barnscarter-ops/portalbox/enclosure/renders/front.png

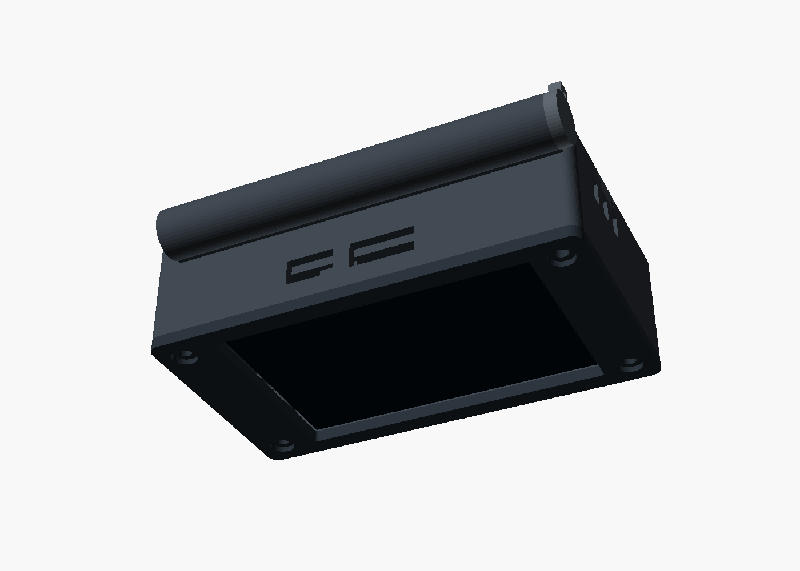
enclosure/renders/front.png
