barnscarter-ops/portalbox/enclosure/renders/rear.png

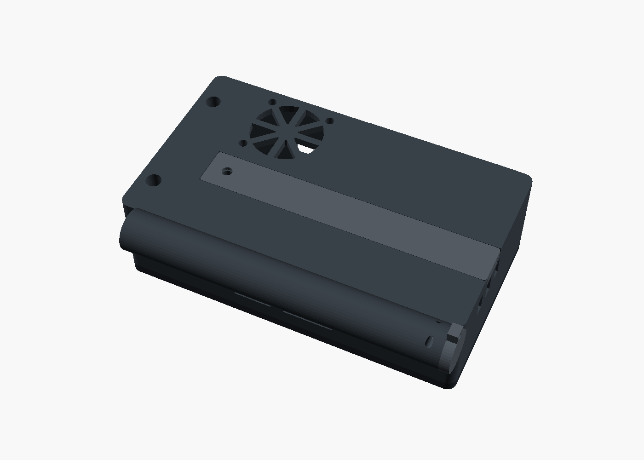
enclosure/renders/rear.png
