barnscarter-ops/portalbox/enclosure/renders/top-edge.png

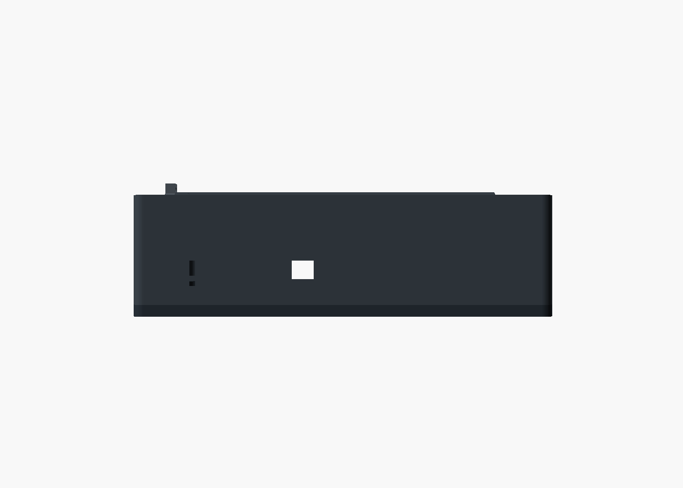
enclosure/renders/top-edge.png
