barnscarter-ops/portalbox/enclosure/draft-stl/button.stl

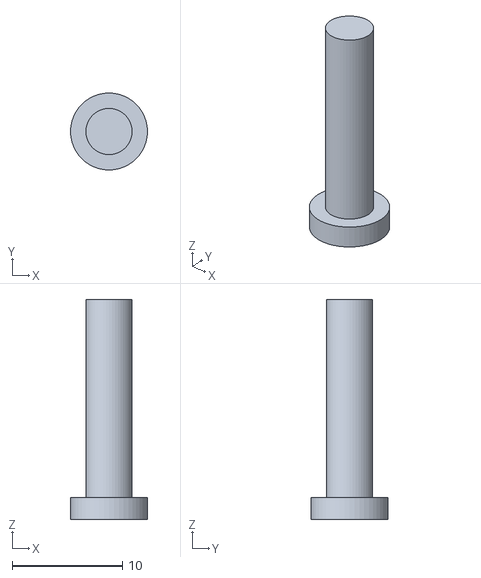
[picture p4: CAD file, 2026-10-12]
enclosure/draft-stl/button.stl
7.00 x 7.00 x 20.0
