barnscarter-ops/portalbox/enclosure/draft-stl/shell.stl

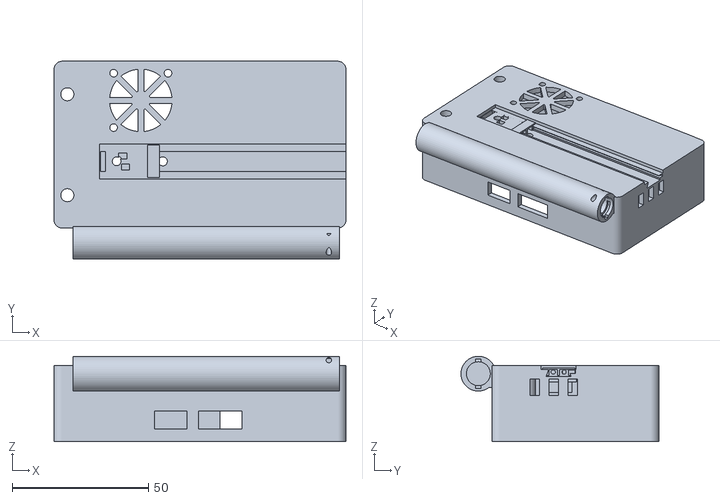
[picture p5: CAD file, 2026-10-12]
enclosure/draft-stl/shell.stl
107.3 x 72.8 x 31.4
