barnscarter-ops/portalbox/enclosure/draft-stl/divider.stl

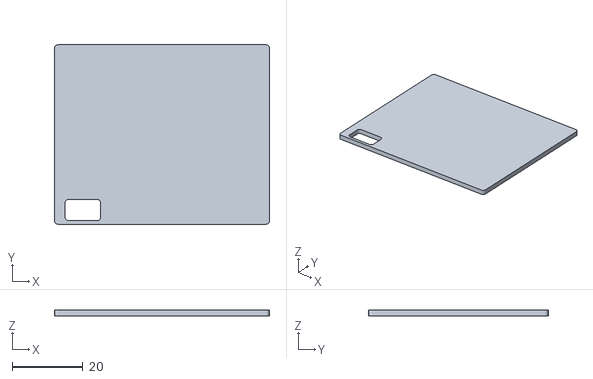
[picture p6: CAD file, 2026-10-12]
enclosure/draft-stl/divider.stl
60.6 x 50.6 x 1.60
