barnscarter-ops/portalbox/enclosure/draft-stl/fit_coupon.stl

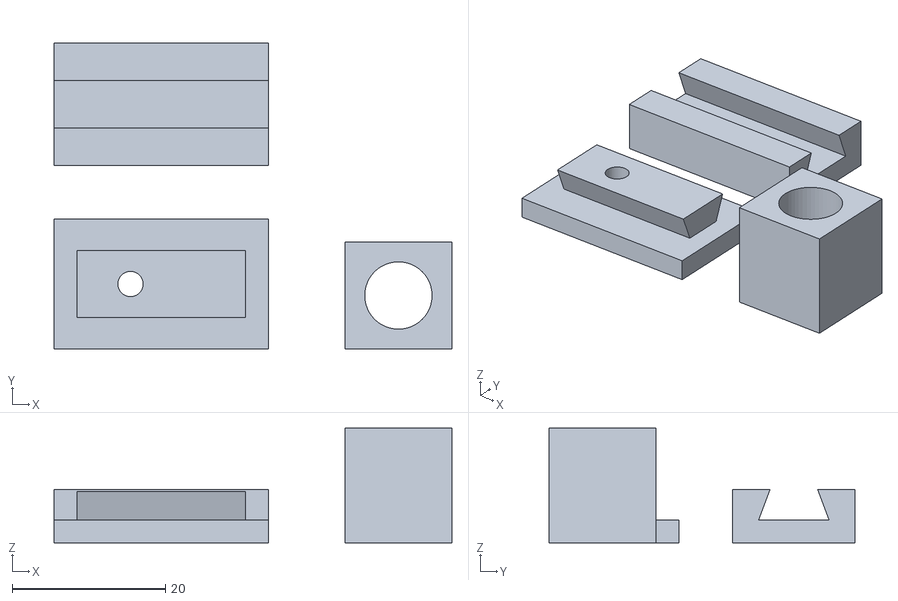
[picture p7: CAD file, 2026-10-12]
enclosure/draft-stl/fit_coupon.stl
52.0 x 40.0 x 15.0
