barnscarter-ops/portalbox/enclosure/draft-stl/pod.stl

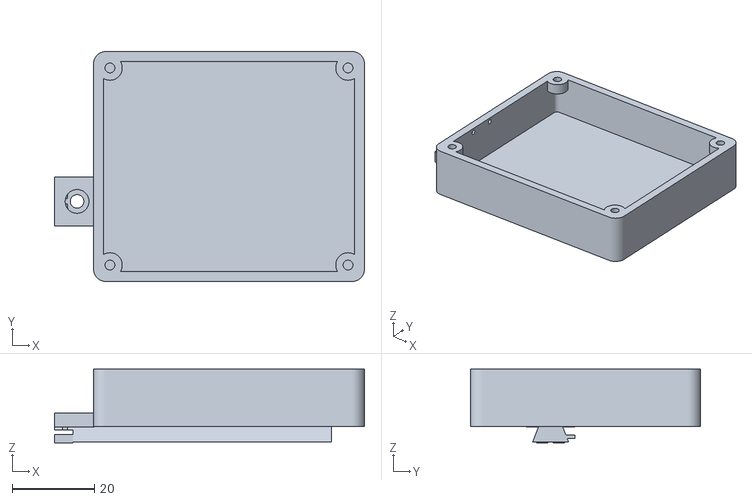
[picture p8: CAD file, 2026-10-12]
enclosure/draft-stl/pod.stl
75.5 x 56.0 x 18.0
