barnscarter-ops/portalbox/enclosure/draft-stl/rail_cover.stl

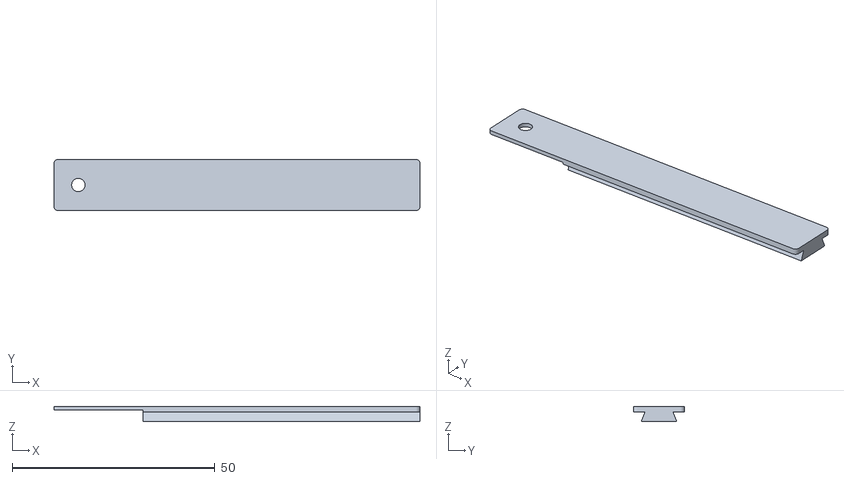
[picture p9: CAD file, 2026-10-12]
enclosure/draft-stl/rail_cover.stl
90.3 x 12.6 x 3.80
