barnscarter-ops/portalbox/enclosure/draft-stl/bezel.stl

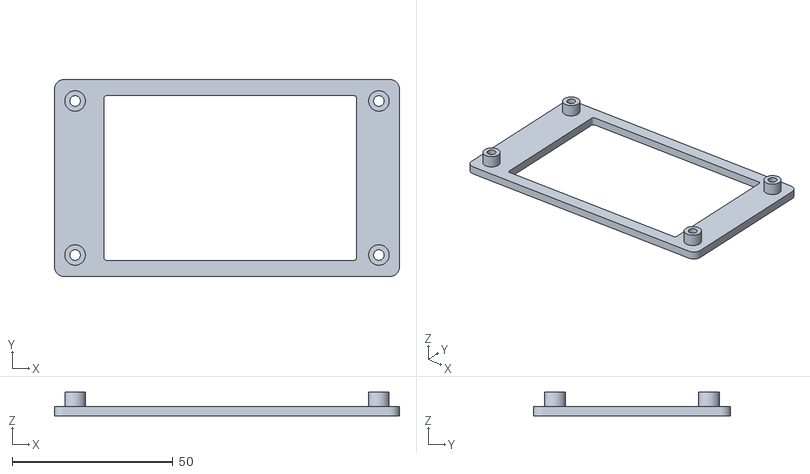
[picture p10: CAD file, 2026-10-12]
enclosure/draft-stl/bezel.stl
107.3 x 61.3 x 7.40
