barnscarter-ops/portalbox/enclosure/draft-stl/stylus_cap.stl

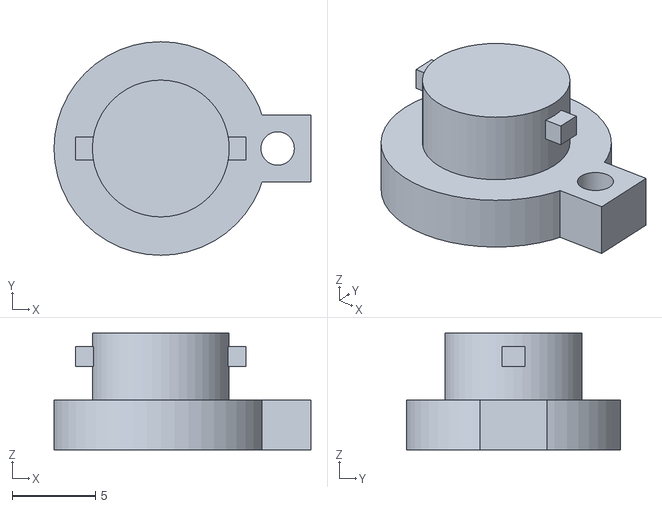
[picture p11: CAD file, 2026-10-12]
enclosure/draft-stl/stylus_cap.stl
15.4 x 12.8 x 7.00
