barnscarter-ops/portalbox/enclosure/draft-stl/pod_lid.stl

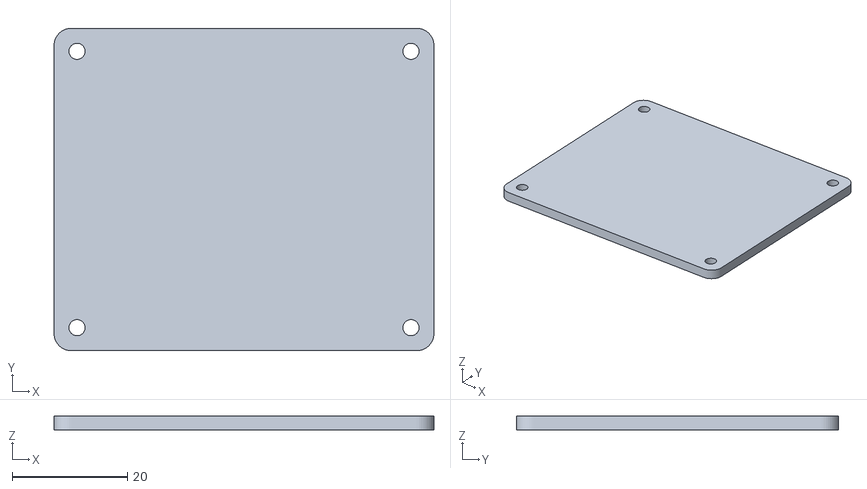
[picture p12: CAD file, 2026-10-12]
enclosure/draft-stl/pod_lid.stl
66.0 x 56.0 x 2.40
