barnscarter-ops/portalbox/enclosure/draft-stl/fit_coupon_20.3mf

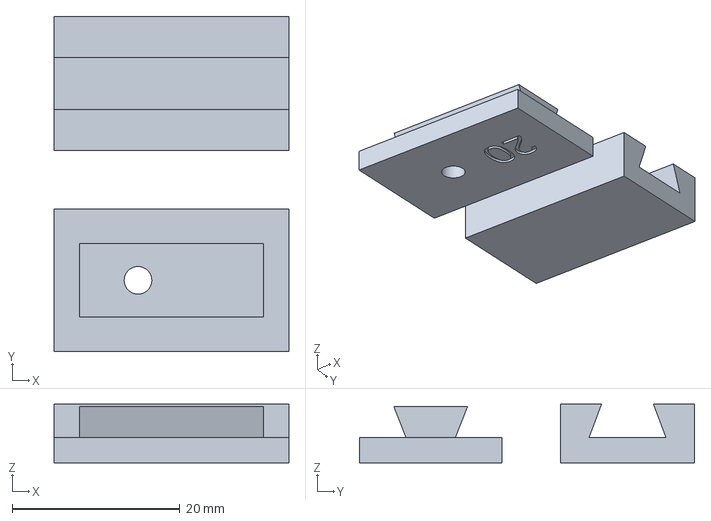
[picture p13: CAD file, 2026-10-04]
enclosure/draft-stl/fit_coupon_20.3mf
28.0 x 40.0 x 7.00 mm
