barnscarter-ops/portalbox/enclosure/draft-stl/fit_coupon_series.stl

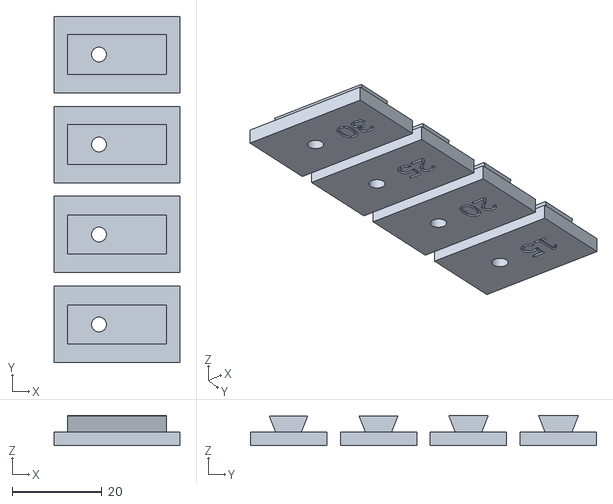
[picture p14: CAD file, 2026-10-03]
enclosure/draft-stl/fit_coupon_series.stl
28.0 x 77.0 x 6.75
