barnscarter-ops/portalbox/enclosure/cyd-case.scad

// CYD 3.5 enclosure, revision 0.3: UNVALIDATED rail electrical design.
// Rear-view coordinates: USB left, I2C upper right. Units: mm.
// LCDWiki E32R35T_Size.pdf is a family reference, not proof of owner-board fit.
part="assembly"; // bezel, shell, rail_cover, stylus_cap, pod, pod_lid, divider, button, fit_coupon
with_pod=false;
$fn=48;
pcb=[101.5,55.5]; gap=0.5; wall=2.4;
W=pcb[0]+2*(gap+wall); H=pcb[1]+2*(gap+wall);
O=gap+wall; depth=31; seam=3;
// Nominal M3 heat-set insert: 4.6 mm OD, about 4.2 mm long. Tune to bought hardware.
insert_od=4.6; insert_seat_d=4.1; insert_seat_depth=4.2;
// Centers from the dimensioned rear drawing after rotating into landscape.
// Owner board checked 2026-09-30: speaker faces rear; BAT faces inward.
// Both stay enclosed. These lists include only outward-facing edge connectors.
upper_ports=[[29.44,8],[64.125,12],[84.125,12]]; // GPIO39/35, SPI, I2C (caliper 2026-10-12: housings 10.25 wide + 1.75 clearance)
lower_ports=[[40.025,12],[58.2,16]]; // UART, microSD (caliper 2026-10-12: UART 10.25 wide, SD 14.9 wide)
port_z=11; port_h=6.5; // provisional vertical offsets / clearances
mounts=[[O+3.5,O+3.8],[O+98,O+3.8],[O+3.5,O+51.7],[O+98,O+51.7]];
buttons=[[O+2,O+46.25],[O+2,O+9.15]]; // RESET (upper edge) / BOOT (UART-SD edge): 2 from USB end, 9.15 from long edge (caliper 2026-10-12)
// Fan x/y start PCB-relative; add O for case coordinates. ESP32 module position
// is unmeasured: confirm final fan center over the module with calipers.
fan=[O+29,O+44]; fan_spacing=20; // Sunon has THREE mounting holes; fourth position unused
fan_holes=[[-10,-10],[-10,10],[10,10]];
rail_x=15; rail_y=18; rail_len=W-rail_x; rail_base=2; rail_h=4;
rail_slop=0.20; // per-side dovetail clearance; PETG fit-tested 2026-10-03 (P1S, 0.20 fit like a glove)
stylus_len=87.31; stylus_bore=8.8; tube_len=98;
tube_y=-5; tube_z=depth-3; tube_x=7;
pod_x=44; pod_y=5; pod_z=depth+rail_slop;
pod_size=[66,56,14]; battery=[60,50,7.3];
boost=[O+52,O+34,16.6]; boost_size=[45,23,10]; // x/y PCB-relative + O; z case-relative
// AXIAL pogo mechanism: 2 x Mill-Max 0947-0-15-20-77-14-11-0 in shell.
// Each: 5.6 A derated (7 A catalogue), 12.217 mm free overall length,
// 2.286 mm stroke; nominal 1.60 mm mounting bore, verify/ream after printing.
// Pod: 2 x Harwin S70-125161545R gold pads, 2.5(y) x 1.6(z) x .15(x), 6 A.
// Pads require separate insulated carriers / solder lands; NOT bare wire blobs.
// Contacts run along x, not rubbing across rail; y pitch 4 mm, z axis 28.6.
// GND lane y=22.5: free tip x=38.0; BAT+ lane y=26.5: x=37.0.
// Both pod pad faces x=36.5 when seated. Insertion (-x): GND makes at
// remaining travel 1.50 mm; BAT+ at .50 mm. Removal: BAT+ breaks FIRST.
// Separate blind pad wells recess live faces 2.00 mm behind hood front x=34.5.
// One-sided shoe rib/rail groove blocks reversed orientation before contacts.
// Lock: ISO 4762 M3x12 screw + heat-set M3 insert; no loose nut or magnets.
// Head counterbore: diameter 5.8, depth 3.2; 3 mm head sits .2 below flange.
// Pin/pad fit, tolerances, force, insulation and >=2 A load require bench tests.
contact_y=[22.5,26.5]; contact_z=28.6; contact_tip_x=[38,37];
contact_face_x=36.5; contact_guard_x=34.5;
contact_stroke=2.286; contact_length=12.217;
contact_bore=1.6; pad_pocket=[2.7,1.8];
module x_bore(x,y,z,d,h){translate([x,y,z]) rotate([0,90,0]) cylinder(d=d,h=h);}
module lock_insert_cut(){
 // Heat-set from shell interior into the existing boss, z=21..25.2 by default.
 // Melted-in retention removes the loose-nut hazard; 1.8 mm roof remains above.
 // Single seat at x=40 replaces BOTH the hex pocket and overlapping rail seat.
 bore(40,rail_y+6.5,20.99,insert_seat_d,insert_seat_depth+0.01);
 bore(40,rail_y+6.5,20.9,3.3,12);
}
module rail_dock(){difference(){union(){
 translate([19,rail_y+0.5,depth-rail_base-rail_h-0.1]) cube([15.45,12,4.6]);
 // Telescoping insulating comb extends .8 mm beyond even the free GND tip.
 // Each metal pin is recessed in its own lane, including when USB is charging.
 for(y=[18.5,24.1,28.1]) translate([34.4,y,27.4]) cube([4.4,y==24.1?0.8:2.4,2.7]);
 translate([34.4,18.5,29.5]) cube([4.4,12,0.6]);
}
 for(i=[0:1]){
  // Bore opens to internal solder-cup access via a separate rear pocket.
  x_bore(contact_tip_x[i]-contact_length,contact_y[i],contact_z,contact_bore,12);
  translate([contact_tip_x[i]-contact_length-1,contact_y[i]-1.1,24.8]) cube([3,2.2,5]);
 }
 // Preserve the flush-cover fastener's existing insert seat.
 bore(rail_x+8,rail_y+6.5,depth-8,insert_seat_d,4);
 bore(rail_x+8,rail_y+6.5,depth-4.1,3.2,5);
}}
module rounded(w,h,z,r=3){linear_extrude(z) hull() for(x=[r,w-r],y=[r,h-r]) translate([x,y]) circle(r);}
module bore(x,y,z,d,h){translate([x,y,z]) cylinder(d=d,h=h);}
module screw_cuts(z,h,d=3.3){for(p=mounts) bore(p[0],p[1],z,d,h);}
module bezel(){difference(){
 union(){rounded(W,H,seam); for(p=mounts) bore(p[0],p[1],seam-0.1,6.4,4.5);}
 // Oversize touch-visible window, with no pressure on resistive touch film.
 // Center: PCB x=51.80, case x=54.70; shift +1.05 toward antenna, same size.
 translate([W/2+1.05-78.6/2,H/2-51.2/2,-1]) rounded(78.6,51.2,5,0.8);
 screw_cuts(-1,10); for(p=mounts) bore(p[0],p[1],-0.01,6.2,1.4);
}}
// Recessed dovetail: reinforcement projects inward; rear surface stays at z=31.
module female_track(){difference(){
 translate([rail_x,rail_y,depth-rail_base-rail_h-0.1]) cube([rail_len,13,rail_base+rail_h+0.1]);
 translate([rail_x+2,rail_y+6.5,depth-rail_h]) rotate([0,90,0])
 linear_extrude(rail_len+1) polygon([[0,-4.6],[-rail_h,-3.1],[-rail_h,3.1],[0,4.6]]);
 // Keep only the cover seat here; pod lock uses its separate heat-set boss.
 for(x=[rail_x+8]){bore(x,rail_y+6.5,depth-8,insert_seat_d,4);
 bore(x,rail_y+6.5,depth-4.1,3.2,5);}
}}
module track_cuts(){
 translate([rail_x+2,rail_y+6.5,depth-rail_h]) rotate([0,90,0])
 linear_extrude(rail_len+1) polygon([[0,-4.6],[-rail_h,-3.1],[-rail_h,3.1],[0,4.6]]);
 translate([rail_x+1.8,rail_y+0.1,depth-1.45]) cube([rail_len,12.8,2]);
 for(x=[rail_x+8]){bore(x,rail_y+6.5,depth-8,insert_seat_d,4);bore(x,rail_y+6.5,depth-4.1,3.2,5);}
 // Asymmetric key groove. Opposite rail wall stays solid.
 translate([contact_guard_x,26.8,28.1]) cube([W-contact_guard_x+2,3.9,1.2]);
 lock_insert_cut();
}
module boost_cradle(){
 // Insulated pad and retaining corner blocks; actual PCB fit pending.
 for(x=[boost[0]-1.5,boost[0]+boost_size[0]],y=[boost[1]-1.5,boost[1]+boost_size[1]])
 translate([x,y,boost[2]+8.5]) cube([1.5,1.5,depth-boost[2]-8.5]);
 for(y=[boost[1]-1.5,boost[1]+boost_size[1]])
 translate([boost[0],y,boost[2]+10]) cube([boost_size[0],1.5,depth-boost[2]-10]);
}
module shoe(len=80,c=rail_slop){rotate([0,90,0]) linear_extrude(len)
 polygon([[0,-4.6+c],[-rail_h+c,-3.1+c],[-rail_h+c,3.1-c],[0,4.6-c]]);}
module edge_cuts(){
 for(p=upper_ports) translate([O+p[0]-p[1]/2,H-wall-1,port_z-port_h/2]) cube([p[1],wall+3,port_h]);
 for(p=lower_ports) translate([O+p[0]-p[1]/2,-1,port_z-port_h/2]) cube([p[1],wall+3,port_h]);
 translate([-1,O+27.75-6,port_z-3.5]) cube([wall+3,12,7]);
 // intake slots on the right edge, behind the PCB components
 for(y=[14:7:28]) translate([W-wall-1,y,20]) cube([wall+3,3.5,6]);
 // USB-C charge input reservation only; exterior battery socket removed.
 translate([72,H-wall-1,20]) cube([14,wall+3,8]);
}
module tube(){difference(){
 union(){translate([tube_x,tube_y,tube_z]) rotate([0,90,0]) cylinder(d=12.8,h=tube_len);
 translate([tube_x,-2,depth-8]) cube([tube_len,4,7]);}
 // Tube has a 2.4 mm blind end wall; cap retains the stylus at handle end.
 translate([tube_x+2.4,tube_y,tube_z]) rotate([0,90,0]) cylinder(d=stylus_bore,h=tube_len+1);
 // Two opposed bayonet entry slots and quarter-turn retaining grooves.
 for(a=[0,180]) translate([tube_x+tube_len-4.2,tube_y,tube_z]) rotate([a,0,0])
 translate([0,-1,-5.4]) cube([5.5,2,1.7]);
 for(a=[0,180]) translate([tube_x+tube_len-3.2,tube_y,tube_z]) rotate([0,90,0])
 rotate([0,0,a]) rotate_extrude(angle=95) translate([4.05,0]) square([1.3,1.6]);
 // cross-hole for a bought silicone tether / cord
 translate([tube_x+tube_len-4,-2,tube_z+5]) rotate([90,0,0]) cylinder(d=2,h=8);
}}
module shell(){union(){difference(){union(){
 difference(){translate([0,0,seam]) rounded(W,H,depth-seam);
 translate([wall,wall,seam-0.1]) rounded(W-2*wall,H-2*wall,depth-seam-wall+0.1,1.2);}
 // Four columns join shell to bezel and support board at its hole locations.
 for(p=mounts) bore(p[0],p[1],9.1,6.4,depth-9.1);
 // Rear button guide sleeves end safely short of switches.
 for(p=buttons) bore(p[0],p[1],16,8,depth-16);
 // Fan frame seats directly against rear skin; no posts invade its envelope.
 tube(); female_track(); boost_cradle();
 // Heat-set lock boss supports repeated tightening without a thin rail skin.
 translate([35,19.5,21]) cube([10,10,6]);
}
 edge_cuts(); track_cuts();
 screw_cuts(8.9,10,2.6); // blind M3 pilots; screws installed from bezel
 // Press-fit insert seats at front ends of columns, not behind battery.
 screw_cuts(9.09,insert_seat_depth,insert_seat_d);
 for(p=buttons) bore(p[0],p[1],15,4.8,depth-13);
 // Fan exhaust with hub and eight integrated spokes, no exposed rotor.
 translate([fan[0],fan[1],depth-wall-0.1]) difference(){
 cylinder(d=23,h=wall+1); cylinder(d=7,h=wall+2);
 for(a=[0:45:315]) rotate([0,0,a]) translate([-1.1,0,-1]) cube([2.2,15,wall+4]);}
 for(v=fan_holes) bore(fan[0]+v[0],fan[1]+v[1],depth-13,2.8,15);
} rail_dock();}}
module rail_cover(){difference(){union(){
 shoe(rail_len-2); translate([0,-6.3,rail_h-rail_slop-1.4]) rounded(rail_len-2,12.6,1.4,1);
} bore(6,0,-1,3.3,9);
 // Flat cover bridges the electrical stop; its shoe clears the dock and pins.
 translate([-1,-6.4,-1]) cube([22.9,12.8,3.85]);
}}
module stylus_cap(){difference(){union(){
 cylinder(d=12.8,h=3); translate([0,0,3]) cylinder(d=8.2,h=4);
 for(a=[0,180]) rotate([0,0,a]) translate([3.8,-0.7,5]) cube([1.3,1.4,1.2]);
 translate([5,-2,0]) cube([4,4,3]);}
 bore(7,0,-1,2,5);
} // bayonet cap; test actual fit before fitting stylus
}
module button(){union(){cylinder(d=4.2,h=20); cylinder(d=7,h=2);}} // 18.5 + 1.5 mm: print-tested push length 2026-10-12
// Battery-only pod; charger stays in main case when pod is detached.
module pod(){difference(){union(){
 difference(){rounded(pod_size[0],pod_size[1],pod_size[2]);
 translate([wall,wall,wall]) rounded(pod_size[0]-2*wall,pod_size[1]-2*wall,pod_size[2],1);}
 for(x=[4,pod_size[0]-4],y=[4,pod_size[1]-4]) bore(x,y,11,6,3);
 // Mechanical dovetail foot, on outside of pod floor
 translate([0,rail_y+6.5-pod_y,-rail_h+rail_slop]) shoe(58);
 // Positive overlap joins foot to floor; avoid coplanar/disconnected STL faces.
 translate([0,rail_y+6.5-pod_y-2.5,-0.1]) cube([58,5,0.2]);
 // One-sided anti-reversal key, inside a matching female-track groove.
 translate([0,27-pod_y,28.3-pod_z]) cube([58,3.45,0.8]);
 // External lock tab: screw path never enters the pouch footprint.
 translate([contact_guard_x-pod_x,rail_y+6.5-pod_y,-rail_h+rail_slop]) shoe(pod_x-contact_guard_x+0.2);
 // Wide lock flange stays ABOVE rear skin; underside follows the dovetail.
 translate([contact_guard_x-pod_x,rail_y+6.5-pod_y-6,-0.1]) cube([pod_x-contact_guard_x+0.2,12,3.45]);
 // Local guarded-contact floor: .6 mm below pads, .2 mm above track bottom.
 translate([contact_guard_x-pod_x,20.5-pod_y,27.2-pod_z]) cube([4.5,8,0.6]);
}
 // Lid pilots, kept above pouch compartment.
 for(x=[4,pod_size[0]-4],y=[4,pod_size[1]-4]) bore(x,y,11,2.4,5);
 // M3x12: head seat case z=31.50, flange z=34.70, screw tip z=19.50.
 // Full nominal 4.2 mm insert engagement; verify tip/component clearance physically.
 bore(-4,rail_y+6.5-pod_y,-5,3.3,10);
 bore(-4,rail_y+6.5-pod_y,0.15,5.8,3.3); // 3.2 mm counterbore + .1 overcut
 // Two isolated front-facing pad wells; the 2.0 mm hood guards live battery pads.
 for(y=contact_y){
  translate([contact_guard_x-pod_x-0.1,y-pod_y-pad_pocket[0]/2,contact_z-pod_z-pad_pocket[1]/2])
   cube([contact_face_x-contact_guard_x+0.1,pad_pocket[0],pad_pocket[1]]);
  // Insulated carrier slot, accessed from above; pad front sits at contact_face_x.
  translate([contact_face_x-pod_x,y-pod_y-1.35,contact_z-pod_z-0.9]) cube([1.2,2.7,6]);
  // Lead tunnels detour around M3 screw and rise inside the LEFT pod wall.
  // They exit above the pouch at z=44, not through its occupied footprint.
  wy=y==contact_y[0]?20.8:28.2; // .15 mm CAD clearance to new head counterbore
  bore(37.2-pod_x,y-pod_y,contact_z-pod_z,1.3,4);
  translate([37.2-pod_x,(y==contact_y[0]?wy:y)-pod_y,32.5-pod_z]) rotate([-90,0,0])
   cylinder(d=1.3,h=1.7);
  x_bore(37.2-pod_x,wy-pod_y,32.5-pod_z,1.3,8);
  bore(45.2-pod_x,wy-pod_y,32.5-pod_z,1.3,11.5);
  x_bore(45.2-pod_x,wy-pod_y,44-pod_z,1.3,3);
 }
 // Reliefs receive the insulating comb; individual pad islands remain separate.
 for(y=[18.3,23.9,27.9])
  translate([contact_guard_x-pod_x-0.1,y-pod_y,27.2-pod_z])
   cube([4.6,y==23.9?1.2:2.8,3.1]);
 translate([contact_guard_x-pod_x-0.1,18.3-pod_y,29.3-pod_z]) cube([4.6,12.4,1]);
} }
module pod_lid(){difference(){rounded(pod_size[0],pod_size[1],2.4);
 for(x=[4,pod_size[0]-4],y=[4,pod_size[1]-4]) bore(x,y,-1,2.8,5);
}}
module divider(){difference(){rounded(pod_size[0]-2*wall-0.6,pod_size[1]-2*wall-0.6,1.6,1);
 // cable passage from pouch JST lead; smooth before assembly
 translate([3,1,-1]) rounded(10,6,4,1);
}}
// Slider matches rail_cover/pod: narrow neck on the plate, wide tip away. Print plate-down; flip it to slide into the groove block.
module coupon_slider(c=rail_slop,label=""){difference(){union(){cube([28,17,3]);
 translate([3,8.5,2.9+rail_h-c]) mirror([0,0,1]) shoe(22,c);} // neck sunk 0.1 into plate for a clean union
 bore(10,8.5,-1,3.3,12);
 // label engraved in the underside, mirrored so it reads correctly once the slider is flipped
 if(label!="") translate([20,8.5,-0.01]) mirror([1,0,0]) linear_extrude(0.4) text(label,size=5,halign="center",valign="center");}}
// Clearance series: labels are per-side clearance in hundredths of a mm (30 = 0.30). Same groove block as fit_coupon.
module fit_coupon_series(){for(i=[0:3]) translate([0,i*20,0]) coupon_slider([0.30,0.25,0.20,0.15][i],str([30,25,20,15][i]));}
// PETG retest: one slider at a single clearance plus the groove block (shoe/dovetail), both print-orientation.
module fit_coupon_20(){coupon_slider(0.20,"20");
 translate([0,24,0]) difference(){cube([28,16,7]);translate([0,8,3]) rotate([0,90,0])
 linear_extrude(30) polygon([[0,-4.6],[-4,-3.1],[-4,3.1],[0,4.6]]);}}
module fit_coupon(){coupon_slider();
 translate([0,24,0]) difference(){cube([28,16,7]);translate([0,8,3]) rotate([0,90,0])
 linear_extrude(30) polygon([[0,-4.6],[-4,-3.1],[-4,3.1],[0,4.6]]);}
 translate([38,0,0]) difference(){cube([14,14,15]);bore(7,7,-1,stylus_bore,18);}
}
module assembly(){
 color([0.15,0.18,0.21]) bezel(); color([0.22,0.25,0.28]) shell();
 // illustrative screen and PCB envelopes, not fabrication geometry
 color([0.02,0.06,0.09]) translate([W/2+1.05-77.84/2,H/2-50.56/2,3.2]) cube([77.84,50.56,1.2]);
 if(with_pod){color([0.32,0.35,0.38]) translate([pod_x,pod_y,pod_z]) pod();
 color([0.19,0.22,0.25]) translate([pod_x,pod_y,pod_z+pod_size[2]]) pod_lid();}
 else color([0.32,0.35,0.38]) translate([rail_x+2,rail_y+6.5,depth-rail_h+rail_slop]) rail_cover();
 color([0.32,0.35,0.38]) translate([tube_x+tube_len+3,tube_y,tube_z]) rotate([0,-90,0]) stylus_cap();
}
if(part=="assembly") assembly();
else if(part=="fit_coupon_series") fit_coupon_series();
else if(part=="fit_coupon_20") fit_coupon_20();
else if(part=="bezel") bezel();
else if(part=="shell") shell();
else if(part=="rail_cover") rail_cover();
else if(part=="stylus_cap") stylus_cap();
else if(part=="pod") pod();
else if(part=="pod_lid") pod_lid();
else if(part=="divider") divider();
else if(part=="button") button();
else if(part=="fit_coupon") fit_coupon();
else if(part=="dock_clearance_check") intersection(){shell();translate([pod_x,pod_y,pod_z]) pod();}
else assert(false,"Unknown part");
