barnscarter-ops/portalbox/(list of files, cad)

Other CAD files:
enclosure/draft-stl/fit_coupon_20.stl
