barnscarter-ops/portalbox/enclosure/renders/battery-installed.png

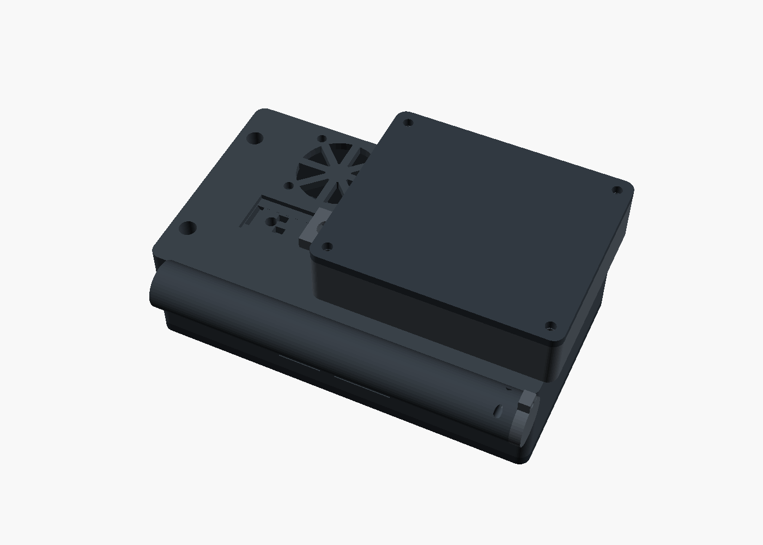
enclosure/renders/battery-installed.png
