barnscarter-ops/portalbox/(commit log)

2026-09-30 initial commit of captive portal for cyd
    [partitions.csv]
2026-09-30 Add CYD enclosure draft with modular battery pod and wiring plan
    [bezel.stl, button.stl, cyd-case.scad, divider.stl, fit_coupon.stl, pod.stl, pod_lid.stl, rail_cover.stl]
2026-09-30 Add interactive hardware illustration for CYD power wiring
2026-10-01 Enclose inward BAT and rear-facing speaker connectors
    [cyd-case.scad, shell.stl]
2026-10-01 Update checklist for 03f8ada connector changes (speaker/BAT no longer edge cutouts)
2026-10-01 Integrate guarded keyed battery contacts into CYD rail
    [cyd-case.scad, pod.stl, rail_cover.stl, shell.stl]
2026-10-02 Add parts/procurement list and handoff note (rail contacts, printer prep)
2026-10-02 Fix audited CYD enclosure geometry and lock hardware
    [bezel.stl, cyd-case.scad, pod.stl, shell.stl]
2026-10-02 Reduce pod lock screw to M3x12 (tighter tip clearance)
    [cyd-case.scad]
2026-10-02 Refresh handoff: parts ordering + printer prep (post-audit)
2026-10-03 Shift illustrative screen envelope +1.05 mm to match recentred bezel window
    [cyd-case.scad]
2026-10-03 Fix fit_coupon slider: narrow neck on plate, wide tip away (matches rail_cover/pod)
    [cyd-case.scad, fit_coupon.stl]
2026-10-03 Add fit_coupon_series: four dovetail sliders at 0.30/0.25/0.20/0.15 mm clearance
    [cyd-case.scad, fit_coupon_series.stl]
2026-10-03 Record fit_coupon_series PLA result: 0.15 mm fits
2026-10-04 Add fit_coupon_20: single 0.20 mm slider + groove block for PETG retest
    [cyd-case.scad, fit_coupon_20.stl]
2026-10-04 Set rail_slop to 0.20 mm from PETG fit test; export with CGAL
    fit_coupon_20 in PETG on the P1S fits cleanly (small corner burr only).
    rail_slop also drives pod_z and rail cover seat, so installed depth is
    47.60 mm. Re-exported STLs, updated viewer, README and parts list.
    export.py pins the CGAL backend (Manifold gave non-manifold shell/pod).
    [bezel.stl, button.stl, cyd-case.scad, divider.stl, fit_coupon.stl, fit_coupon_20.3mf, pod.stl, pod_lid.stl]
2026-10-04 Fix stale audit assert and viewer hardware offsets; refresh dimension audit
    Contact guard hood is 2.0 mm in CAD (assert said 2.2). Viewer booster and
    fan boxes were missing the +2.9 mm board offset the CAD applies.
2026-10-12 Update parts order status; set rail_slop to 0.20 for PETG retest
2026-10-12 Apply caliper measurements: connector openings, button positions, +1.5 mm plunger
2026-10-12 Regenerate exports, renders, viewer meshes and audit for caliper-measured buttons/ports
    export.py: pass --backend CGAL only when the OpenSCAD build supports it (2021.01 is CGAL-only).
